Jaydenye-jr/2026_Grp_12_CompStruct_1D/build/vivado/Rhythm Heaven.runs/impl_1/.init_design.begin.rst

<?xml version="1.0"?>
<ProcessHandle Version="1" Minor="0">
    <Process Command=".planAhead." Owner="jayde" Host="JAYZENBOOK" Pid="61060">
    </Process>
</ProcessHandle>
