Jaydenye-jr/2026_Grp_12_CompStruct_1D/documentation/poster.pdf

# RhythMania

A simple and intuitive rhythm-matching game.

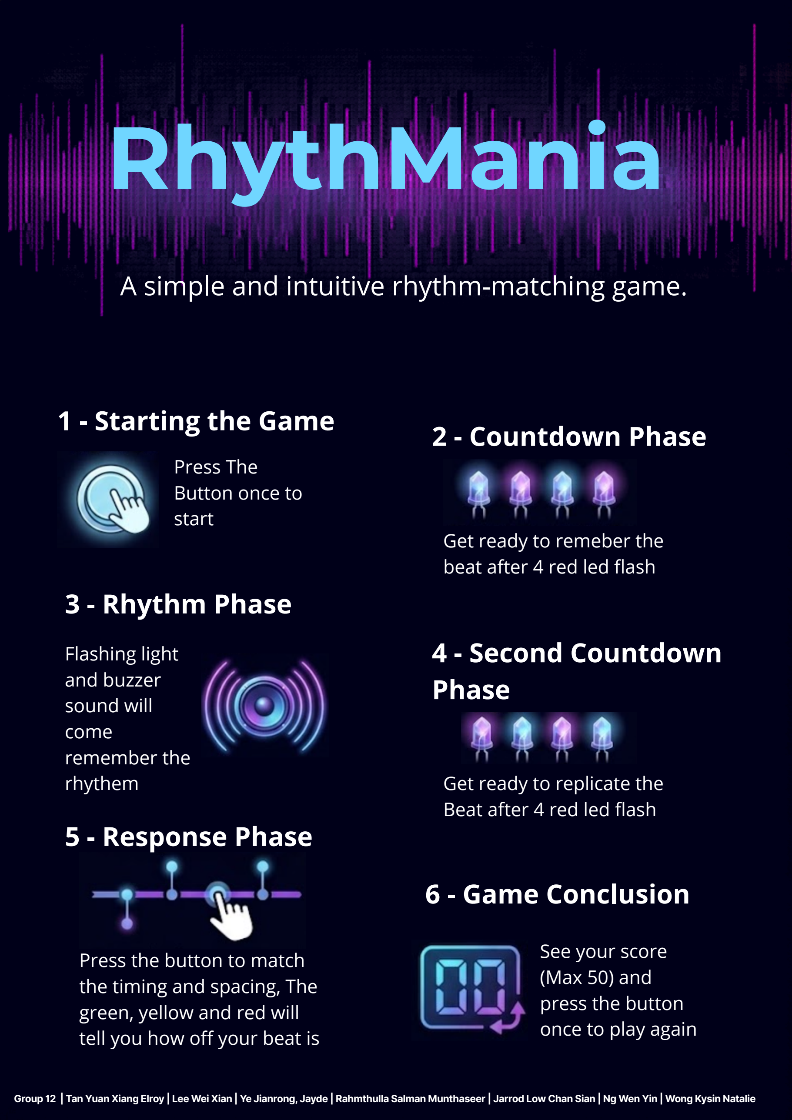
[picture p32: page 1]

## 4 - Second Countdown Phase

## 1 - Starting the Game

Press The
Button once to
start

## 2 - Countdown Phase

Get ready to remeber the
beat after 4 red led flash

## 3 - Rhythm Phase

Flashing light
and buzzer
sound will
come
remember the
rhythem | Get ready to replicate the
| Beat after 4 red led flash

## 5 - Response Phase

Press the button to match
the timing and spacing, The green, yellow and red will tell you how off your beat is

## 6 - Game Conclusion

See your score
(Max 50) and
press the button
once to play again
Group 12 | Tan Yuan Xiang Elroy | Lee Wei Xian | Ye Jianrong, Jayde | Rahmthulla Salman Munthaseer | Jarrod Low Chan Sian | Ng Wen Yin | Wong Kysin Natalie
