Jaydenye-jr/2026_Grp_12_CompStruct_1D/build/vivado/Rhythm Heaven.runs/impl_1/clockInfo.txt

-------------------------------------
| Tool Version : Vivado v.2025.2
| Date         : Wed Apr 15 00:28:04 2026
| Host         : JayZenbook
| Design       : design_1
| Device       : xc7a35t-ftg256-1--
-------------------------------------

For more information on clockInfo.txt clock routing debug file see https://support.xilinx.com/s/article/000035660?language=en_US
