Jaydenye-jr/2026_Grp_12_CompStruct_1D/build/vivado/Rhythm Heaven.runs/synth_1/.vivado.begin.rst

<?xml version="1.0"?>
<ProcessHandle Version="1" Minor="0">
    <Process Command="vivado.bat" Owner="jayde" Host="JAYZENBOOK" Pid="51400" HostCore="22" HostMemory="016506007552">
    </Process>
</ProcessHandle>
